robotronik/cdfr2020ShieldCerveauCapteursActionneursElec/README.txt

Ce fichier a pour but d'expliciter les différents composants de la carte électronique afin d'en faciliter la compréhension.

LevelShifter_ToF :
