robotronik/cdfr2020ShieldCerveauCapteursActionneursElec/shield_etage2.kicad_pcb

## KiCad design shield_etage2.kicad_pcb (2020-07-10)

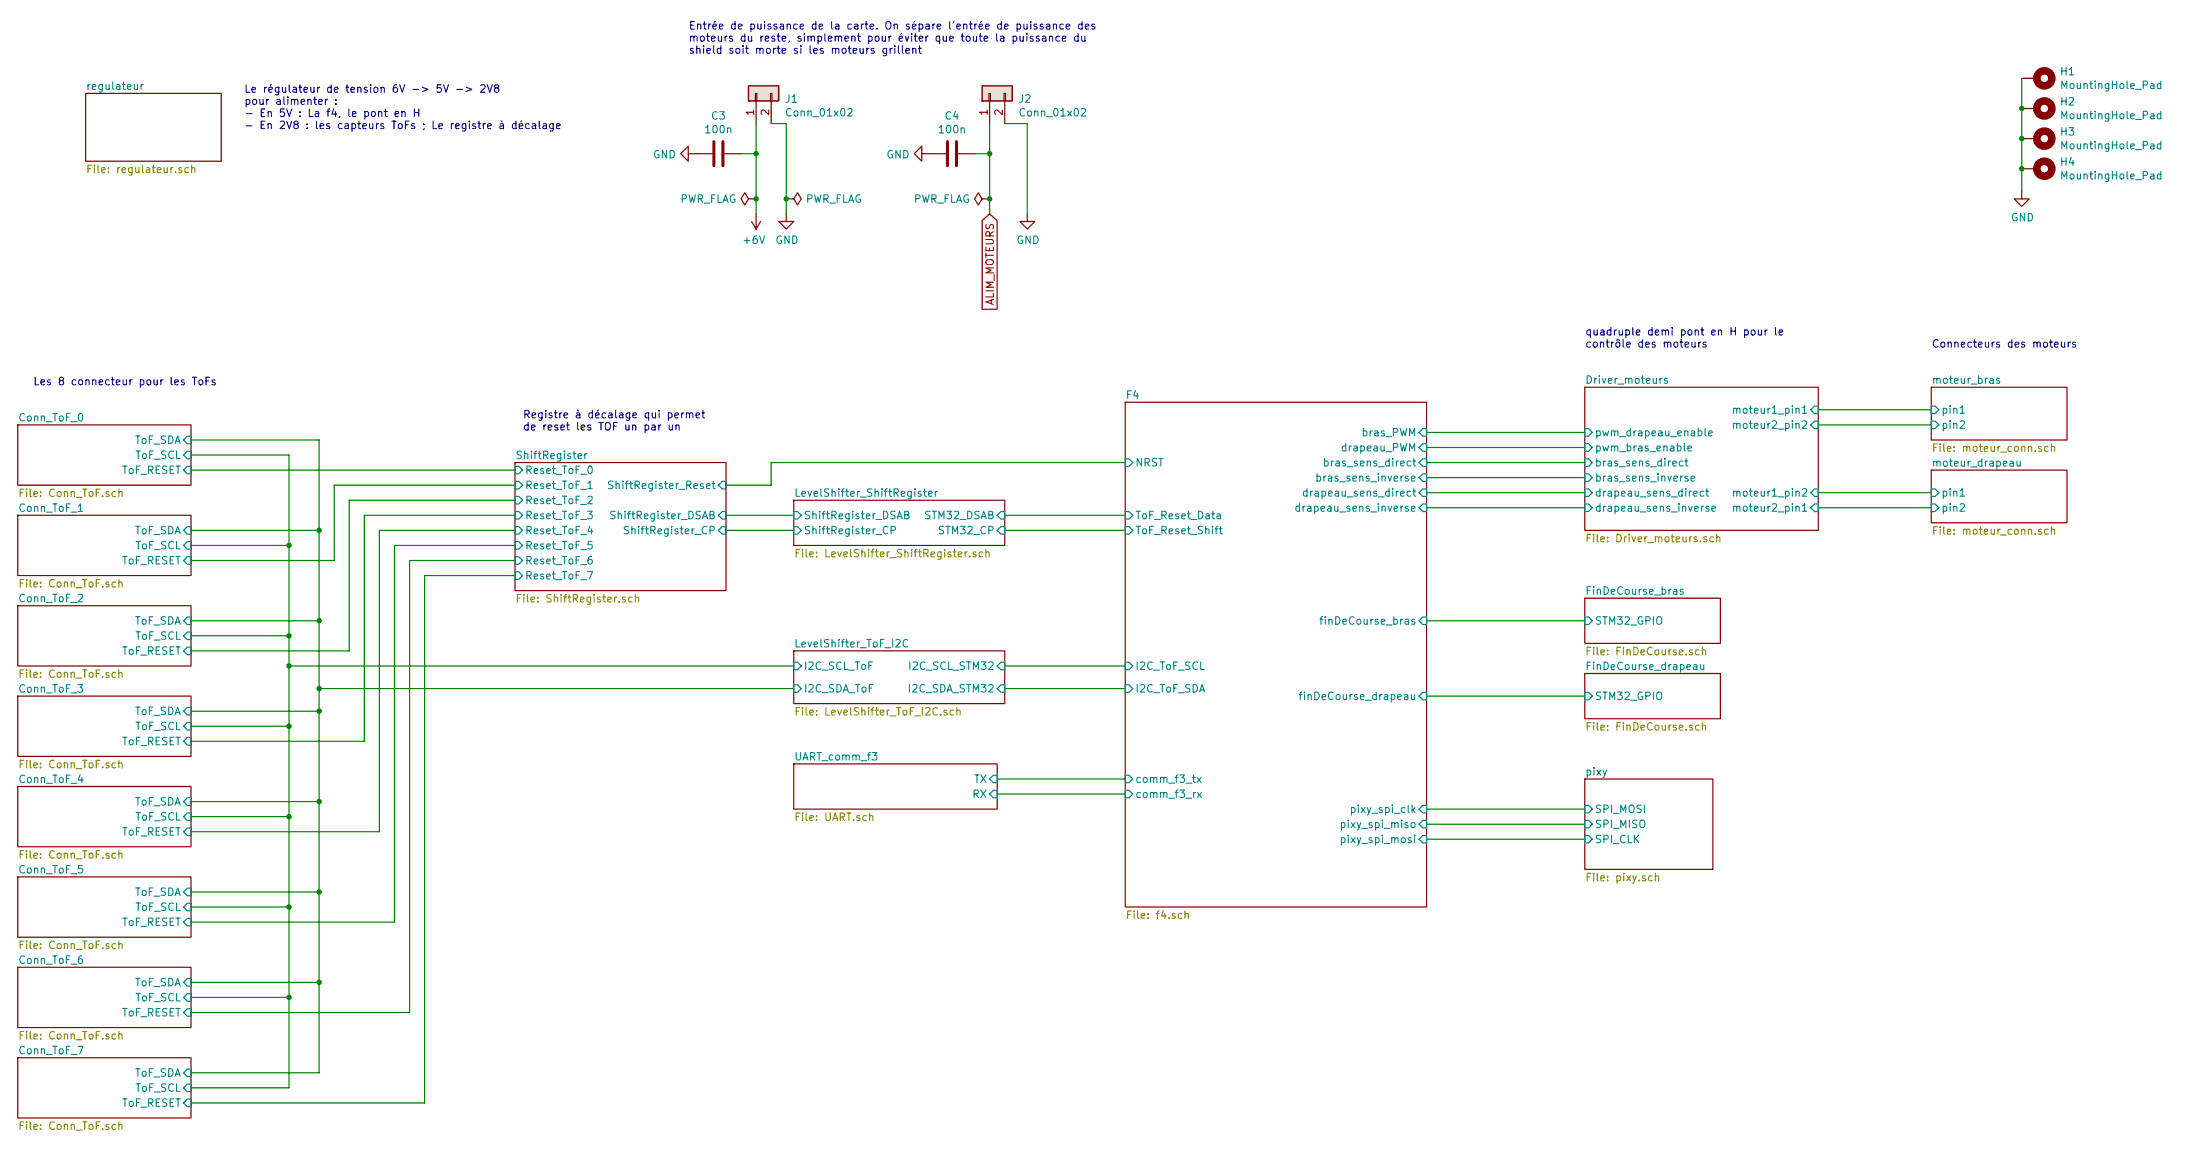
[picture p1: schematic shield_etage2.sch]

Parts:
C3, C4: 100n; C_0805_2012Metric_Pad1.15x1.40mm_HandSolder
H1, H2, H3, H4: MountingHole_Pad; MountingHole_2.2mm_M2_Pad
J1, J2: Conn_01x02; JST_EH_B2B-EH-A_1x02_P2.50mm_Vertical

Connections:
+6V: C3.1, J1.1; also elsewhere on the board
ALIM_MOTEURS: C4.1, J2.1; also elsewhere on the board
GND: C3.2, C4.2, H1.1, H2.1, H3.1, H4.1, J1.2, J2.2; also elsewhere on the board

Notes on the sheet:
Les 8 connecteur pour les ToFs
Registre à décalage qui permet de reset les TOF un par un
quadruple demi pont en H pour le contrôle des moteurs
Connecteurs des moteurs
Le régulateur de tension 6V -> 5V -> 2V8 pour alimenter : - En 5V : La f4, le pont en H - En 2V8 : les capteurs ToFs ; Le registre à décalage
Entrée de puissance de la carte. On sépare l'entrée de puissance des moteurs du reste, simplement pour éviter que toute la puissance du shield soit morte si les moteurs grillent

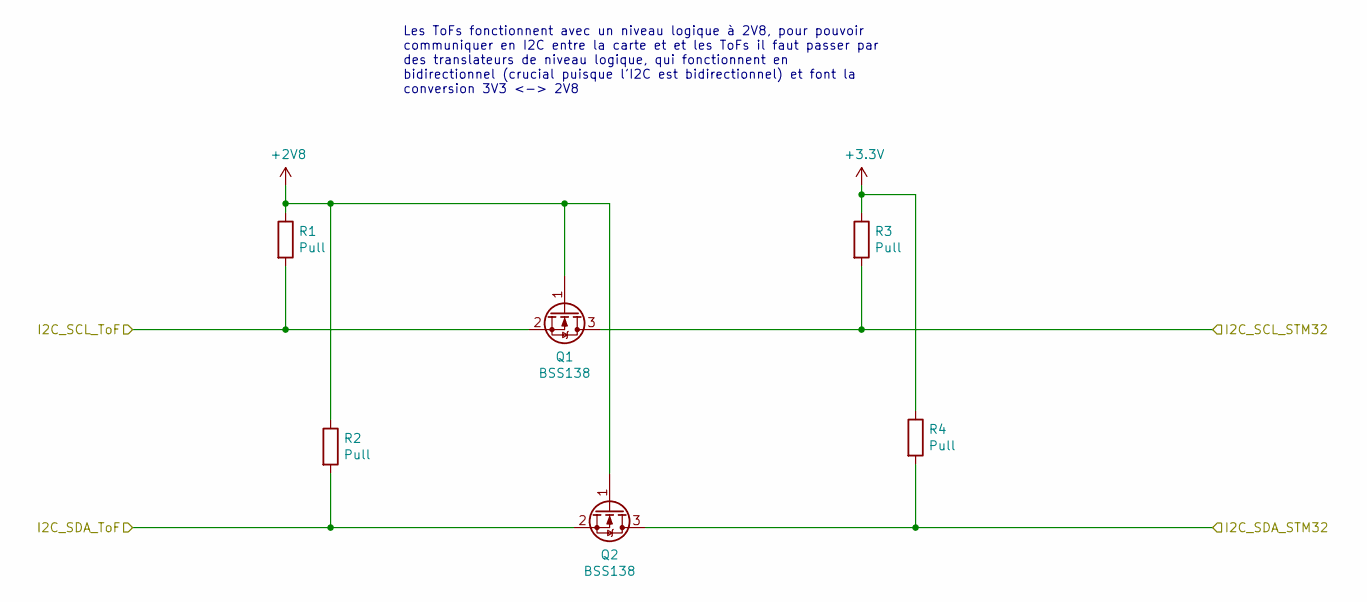
[picture p2: schematic LevelShifter_ToF_I2C.sch]

Parts:
Q1, Q2: BSS138; SOT-23
R1, R2, R3, R4: Pull; R_0805_2012Metric_Pad1.15x1.40mm_HandSolder

Connections:
+2V8: Q1.1 (G), Q2.1 (G), R1.1, R2.1; also elsewhere on the board
/LevelShifter_ToF_I2C/I2C_SCL_STM32: Q1.3 (D), R3.2; also elsewhere on the board
/LevelShifter_ToF_I2C/I2C_SCL_ToF: Q1.2 (S), R1.2; also elsewhere on the board
/LevelShifter_ToF_I2C/I2C_SDA_STM32: Q2.3 (D), R4.2; also elsewhere on the board
/LevelShifter_ToF_I2C/I2C_SDA_ToF: Q2.2 (S), R2.2; also elsewhere on the board

Notes on the sheet:
Les ToFs fonctionnent avec un niveau logique à 2V8, pour pouvoir communiquer en I2C entre la carte et et les ToFs il faut passer par des translateurs de niveau logique, qui fonctionnent en bidirectionnel (crucial puisque l'I2C est bidirectionnel) et font la conversion 3V3 <-> 2V8

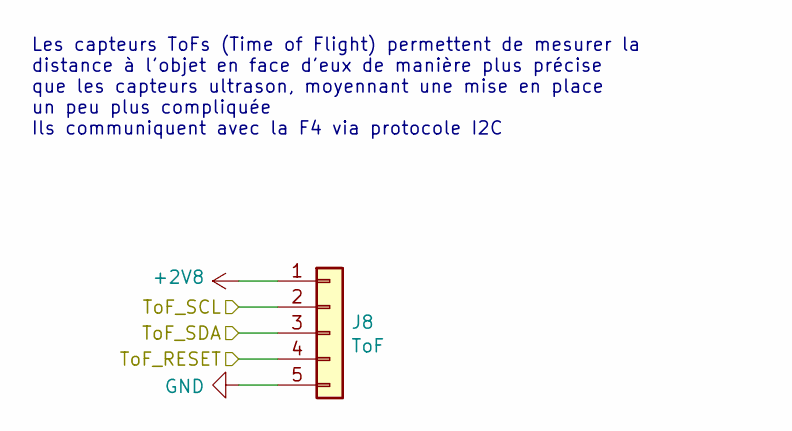
[picture p3: schematic Conn_ToF.sch]

Parts:
J3: ToF; JST_PH_B5B-PH-K_1x05_P2.00mm_Vertical

Connections:
+2V8: J3.1; also elsewhere on the board
/LevelShifter_ToF_I2C/I2C_SCL_ToF: J3.2; also elsewhere on the board
/LevelShifter_ToF_I2C/I2C_SDA_ToF: J3.3; also elsewhere on the board
/ShiftRegister/Reset_ToF_0: J3.4; also elsewhere on the board
GND: J3.5; also elsewhere on the board

Parts of its further copies:
J4, J5, J6, J7, J8, J9, J10: ToF; JST_PH_B5B-PH-K_1x05_P2.00mm_Vertical

Connections of its further copies:
+2V8: J4.1, J5.1, J6.1, J7.1, J8.1, J9.1, J10.1; also elsewhere on the board
/LevelShifter_ToF_I2C/I2C_SCL_ToF: J4.2, J5.2, J6.2, J7.2, J8.2, J9.2, J10.2; also elsewhere on the board
/LevelShifter_ToF_I2C/I2C_SDA_ToF: J4.3, J5.3, J6.3, J7.3, J8.3, J9.3, J10.3; also elsewhere on the board
/ShiftRegister/Reset_ToF_1: J4.4; also elsewhere on the board
/ShiftRegister/Reset_ToF_2: J5.4; also elsewhere on the board
/ShiftRegister/Reset_ToF_3: J6.4; also elsewhere on the board
/ShiftRegister/Reset_ToF_4: J7.4; also elsewhere on the board
/ShiftRegister/Reset_ToF_5: J8.4; also elsewhere on the board
/ShiftRegister/Reset_ToF_6: J9.4; also elsewhere on the board
/ShiftRegister/Reset_ToF_7: J10.4; also elsewhere on the board
GND: J4.5, J5.5, J6.5, J7.5, J8.5, J9.5, J10.5; also elsewhere on the board

Notes on the sheet:
Les capteurs ToFs (Time of Flight) permettent de mesurer la distance à l'objet en face d'eux de manière plus précise que les capteurs ultrason, moyennant une mise en place un peu plus compliquée Ils communiquent avec la F4 via protocole I2C

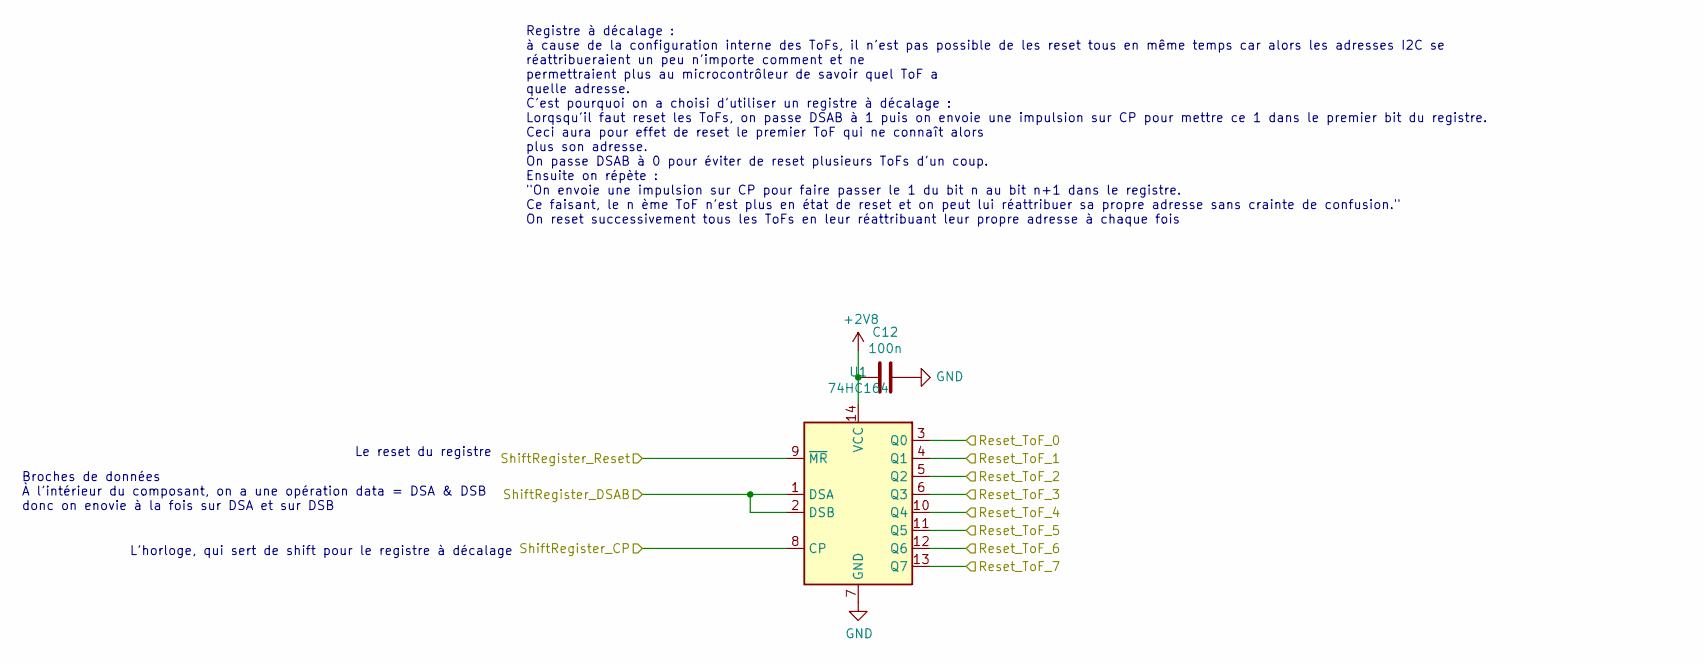
[picture p4: schematic ShiftRegister.sch]

Parts:
C12: 100n; C_0805_2012Metric_Pad1.15x1.40mm_HandSolder
U1: 74HC164; SOIC-14_3.9x8.7mm_P1.27mm

Connections:
+2V8: C12.2, U1.14 (VCC); also elsewhere on the board
/F4/NRST: U1.9 (~MR); also elsewhere on the board
/LevelShifter_ShiftRegister/ShiftRegister_CP: U1.8 (CP); also elsewhere on the board
/LevelShifter_ShiftRegister/ShiftRegister_DSAB: U1.1 (DSA), U1.2 (DSB); also elsewhere on the board
/ShiftRegister/Reset_ToF_0: U1.3 (Q0); also elsewhere on the board
/ShiftRegister/Reset_ToF_1: U1.4 (Q1); also elsewhere on the board
/ShiftRegister/Reset_ToF_2: U1.5 (Q2); also elsewhere on the board
/ShiftRegister/Reset_ToF_3: U1.6 (Q3); also elsewhere on the board
/ShiftRegister/Reset_ToF_4: U1.10 (Q4); also elsewhere on the board
/ShiftRegister/Reset_ToF_5: U1.11 (Q5); also elsewhere on the board
/ShiftRegister/Reset_ToF_6: U1.12 (Q6); also elsewhere on the board
/ShiftRegister/Reset_ToF_7: U1.13 (Q7); also elsewhere on the board
GND: C12.1, U1.7 (GND); also elsewhere on the board

Notes on the sheet:
Broches de données À l'intérieur du composant, on a une opération data = DSA & DSB donc on enovie à la fois sur DSA et sur DSB
L'horloge, qui sert de shift pour le registre à décalage
Le reset du registre
Registre à décalage : à cause de la configuration interne des ToFs, il n'est pas possible de les reset tous en même temps car alors les adresses I2C se réattribueraient un peu n'importe comment et ne permettraient plus au microcontrôleur de savoir quel ToF a quelle adresse. C'est pourquoi on a choi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

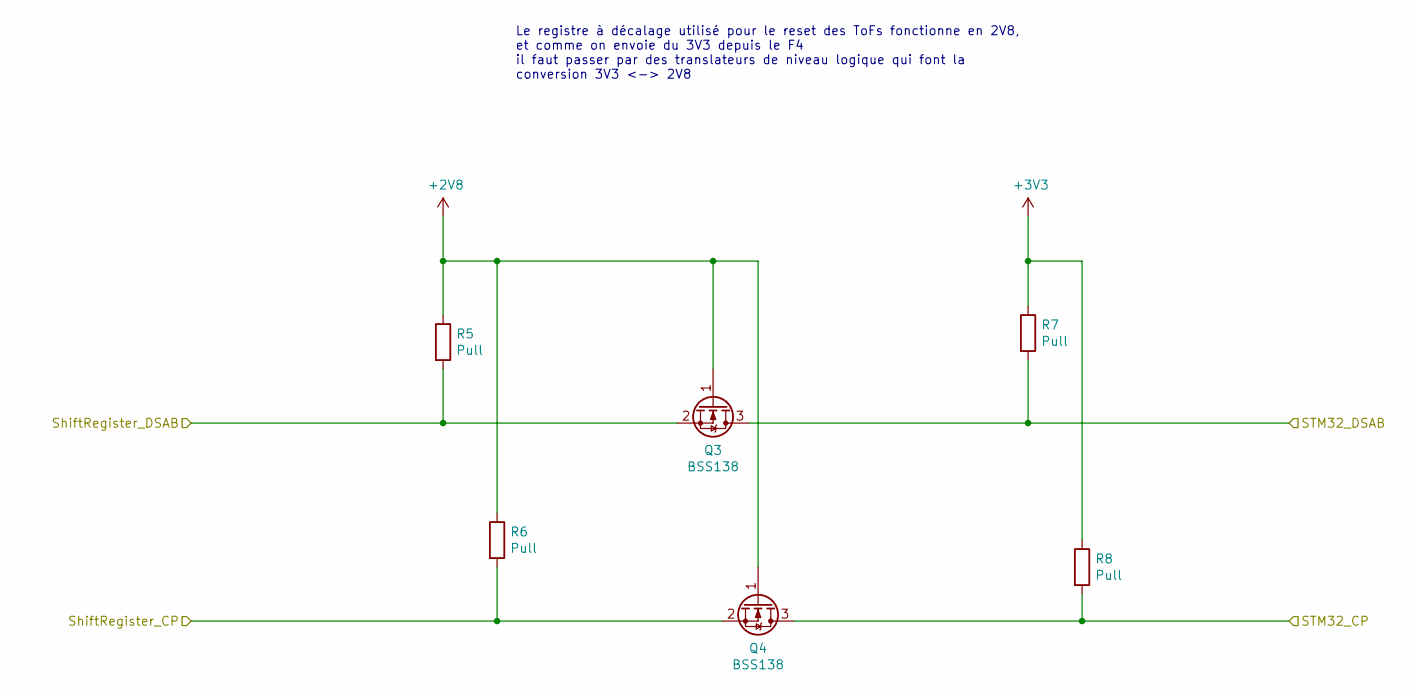
[picture p5: schematic LevelShifter_ShiftRegister.sch]

Parts:
Q3, Q4: BSS138; SOT-23
R5, R6, R7, R8: Pull; R_0805_2012Metric_Pad1.15x1.40mm_HandSolder

Connections:
+2V8: Q3.1 (G), Q4.1 (G), R5.1, R6.1; also elsewhere on the board
/LevelShifter_ShiftRegister/STM32_CP: Q4.3 (D), R8.2; also elsewhere on the board
/LevelShifter_ShiftRegister/STM32_DSAB: Q3.3 (D), R7.2; also elsewhere on the board
/LevelShifter_ShiftRegister/ShiftRegister_CP: Q4.2 (S), R6.2; also elsewhere on the board
/LevelShifter_ShiftRegister/ShiftRegister_DSAB: Q3.2 (S), R5.2; also elsewhere on the board

Notes on the sheet:
Le registre à décalage utilisé pour le reset des ToFs fonctionne en 2V8, et comme on envoie du 3V3 depuis le F4 il faut passer par des translateurs de niveau logique qui font la conversion 3V3 <-> 2V8

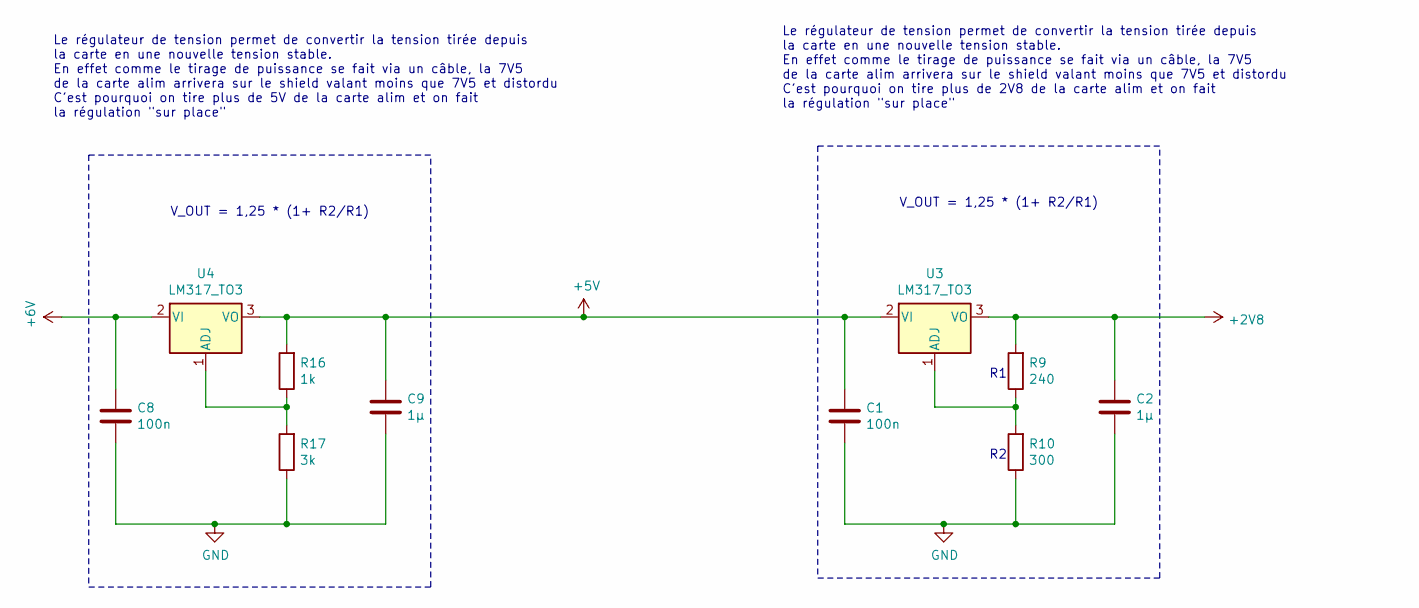
[picture p6: schematic regulateur.sch]

Parts:
C1, C8: 100n; C_0805_2012Metric_Pad1.15x1.40mm_HandSolder
C2, C9: 1µ; C_0805_2012Metric_Pad1.15x1.40mm_HandSolder
R9: 240; R_0805_2012Metric_Pad1.15x1.40mm_HandSolder
R10: 300; R_0805_2012Metric_Pad1.15x1.40mm_HandSolder
R16: 1k; R_0805_2012Metric_Pad1.15x1.40mm_HandSolder
R17: 3k; R_0805_2012Metric_Pad1.15x1.40mm_HandSolder
U3, U4: LM317_TO3; TO-220-3_Vertical

Connections:
+2V8: C2.1, R9.2, U3.3 (VO); also elsewhere on the board
+5V: C1.1, C9.1, R16.2, U3.2 (VI), U4.3 (VO); also elsewhere on the board
+6V: C8.1, U4.2 (VI); also elsewhere on the board
GND: C1.2, C2.2, C8.2, C9.2, R10.1, R17.1; also elsewhere on the board
unnamed: R9.1, R10.2, U3.1 (ADJ)
unnamed: R16.1, R17.2, U4.1 (ADJ)

Notes on the sheet:
V_OUT = 1,25 * (1+ R2/R1)
Le régulateur de tension permet de convertir la tension tirée depuis la carte en une nouvelle tension stable. En effet comme le tirage de puissance se fait via un câble, la 7V5 de la carte alim arrivera sur le shield valant moins que 7V5 et distordu C'est pourquoi on tire plus de 5V de la carte ali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
Le régulateur de tension permet de convertir la tension tirée depuis la carte en une nouvelle tension stable. En effet comme le tirage de puissance se fait via un câble, la 7V5 de la carte alim arrivera sur le shield valant moins que 7V5 et distordu C'est pourquoi on tire plus de 2V8 de la carte al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

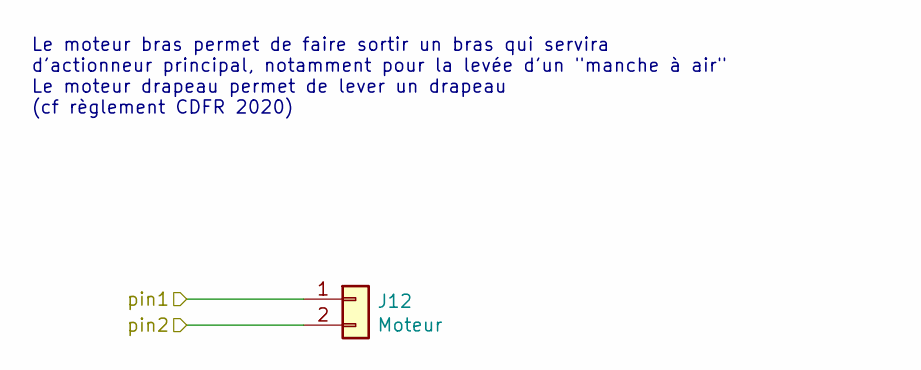
[picture p7: schematic moteur_conn.sch]

Parts:
J12: Moteur; JST_PH_B2B-PH-K_1x02_P2.00mm_Vertical

Connections:
/Driver_moteurs/moteur1_pin2: J12.1; also elsewhere on the board
/Driver_moteurs/moteur2_pin1: J12.2; also elsewhere on the board

Parts of its further copies:
J11: Moteur; JST_PH_B2B-PH-K_1x02_P2.00mm_Vertical

Connections of its further copies:
/Driver_moteurs/moteur1_pin1: J11.1; also elsewhere on the board
/Driver_moteurs/moteur2_pin2: J11.2; also elsewhere on the board

Notes on the sheet:
Le moteur bras permet de faire sortir un bras qui servira d'actionneur principal, notamment pour la levée d'un "manche à air" Le moteur drapeau permet de lever un drapeau (cf règlement CDFR 2020)

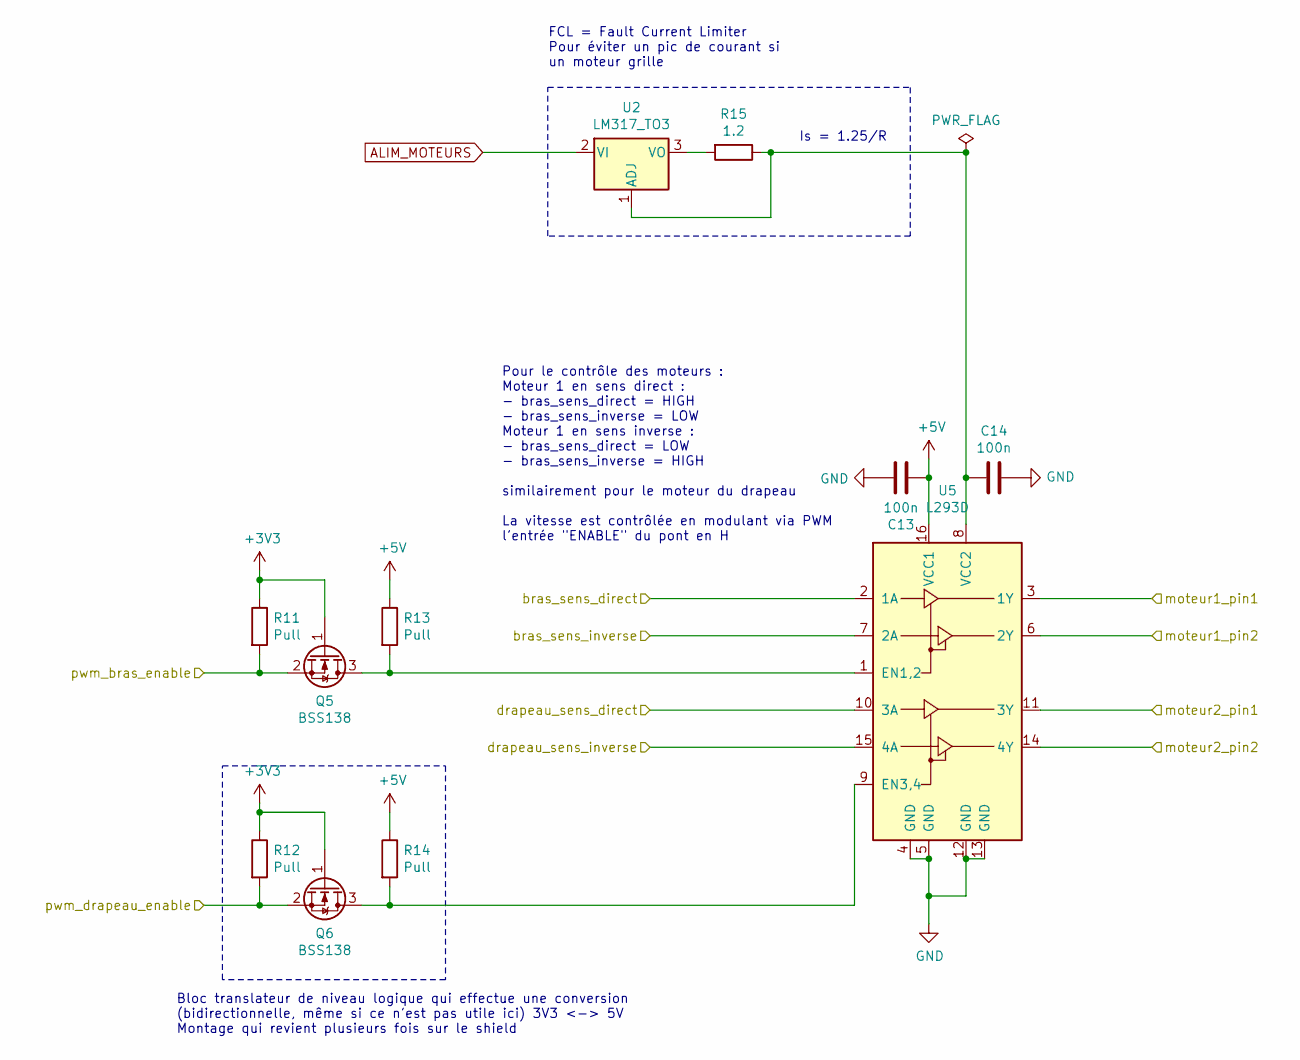
[picture p8: schematic Driver_moteurs.sch]

Parts:
C13, C14: 100n; C_0805_2012Metric_Pad1.15x1.40mm_HandSolder
Q5, Q6: BSS138; SOT-23
R11, R12, R13, R14: Pull; R_0805_2012Metric_Pad1.15x1.40mm_HandSolder
R15: 1.2; R_Axial_DIN0414_L11.9mm_D4.5mm_P15.24mm_Horizontal
U2: LM317_TO3; TO-220-3_Vertical
U5: L293D; DIP-16_W7.62mm

Connections:
+5V: C13.2, R13.1, R14.1, U5.16 (VCC1); also elsewhere on the board
/Driver_moteurs/bras_sens_direct: U5.2 (1A); also elsewhere on the board
/Driver_moteurs/bras_sens_inverse: U5.7 (2A); also elsewhere on the board
/Driver_moteurs/drapeau_sens_direct: U5.10 (3A); also elsewhere on the board
/Driver_moteurs/drapeau_sens_inverse: U5.15 (4A); also elsewhere on the board
/Driver_moteurs/moteur1_pin1: U5.3 (1Y); also elsewhere on the board
/Driver_moteurs/moteur1_pin2: U5.6 (2Y); also elsewhere on the board
/Driver_moteurs/moteur2_pin1: U5.11 (3Y); also elsewhere on the board
/Driver_moteurs/moteur2_pin2: U5.14 (4Y); also elsewhere on the board
/F4/bras_PWM: Q6.2 (S), R12.2; also elsewhere on the board
/F4/drapeau_PWM: Q5.2 (S), R11.2; also elsewhere on the board
ALIM_MOTEURS: U2.2 (VI); also elsewhere on the board
GND: C13.1, C14.1, U5.4 (GND), U5.5 (GND), U5.12 (GND), U5.13 (GND); also elsewhere on the board
unnamed: C14.2, R15.1, U2.1 (ADJ), U5.8 (VCC2)
unnamed: Q5.3 (D), R13.2, U5.1 (EN1,2)
unnamed: Q6.3 (D), R14.2, U5.9 (EN3,4)
unnamed: R15.2, U2.3 (VO)

Notes on the sheet:
FCL = Fault Current Limiter Pour éviter un pic de courant si un moteur grille
Is = 1.25/R
Bloc translateur de niveau logique qui effectue une conversion (bidirectionnelle, même si ce n'est pas utile ici) 3V3 <-> 5V Montage qui revient plusieurs fois sur le shield
Pour le contrôle des moteurs : Moteur 1 en sens direct : - bras_sens_direct = HIGH - bras_sens_inverse = LOW Moteur 1 en sens inverse : - bras_sens_direct = LOW - bras_sens_inverse = HIGH similairement pour le moteur du drapeau La vitesse est contrôlée en modulant via PWM l'entrée "ENABLE" du pont 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

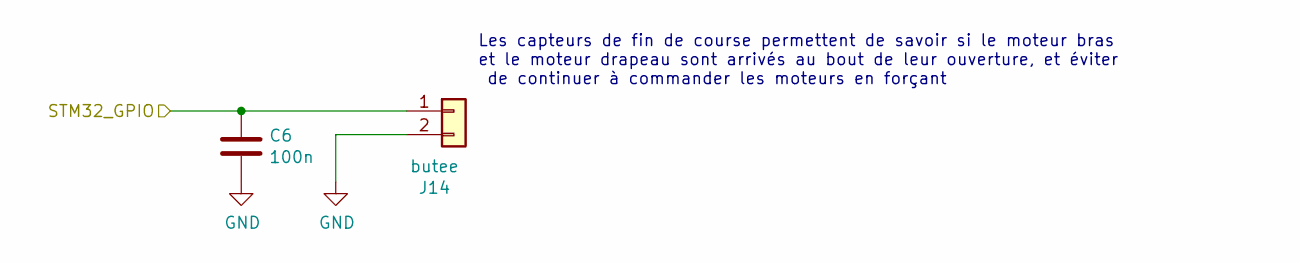
[picture p9: schematic FinDeCourse.sch]

Parts:
C6: 100n; C_0805_2012Metric_Pad1.15x1.40mm_HandSolder
J13: butee; JST_PH_B2B-PH-K_1x02_P2.00mm_Vertical

Connections:
GND: C6.2, J13.2; also elsewhere on the board

Parts of its further copies:
C7: 100n; C_0805_2012Metric_Pad1.15x1.40mm_HandSolder
J14: butee; JST_PH_B2B-PH-K_1x02_P2.00mm_Vertical

Connections of its further copies:
GND: C7.2, J14.2; also elsewhere on the board

Notes on the sheet:
Les capteurs de fin de course permettent de savoir si le moteur bras et le moteur drapeau sont arrivés au bout de leur ouverture, et éviter de continuer à commander les moteurs en forçant

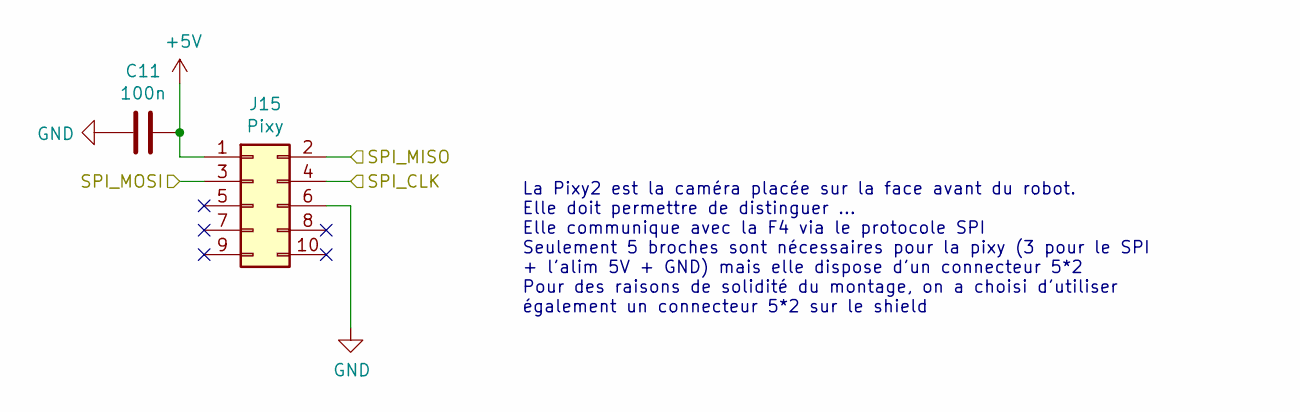
[picture p10: schematic pixy.sch]

Parts:
C11: 100n; C_0805_2012Metric_Pad1.15x1.40mm_HandSolder
J15: Pixy; JST_PHD_B10B-PHDSS_2x05_P2.00mm_Vertical

Connections:
+5V: C11.1, J15.1; also elsewhere on the board
/pixy/SPI_CLK: J15.4; also elsewhere on the board
/pixy/SPI_MISO: J15.2; also elsewhere on the board
/pixy/SPI_MOSI: J15.3; also elsewhere on the board
GND: C11.2, J15.6; also elsewhere on the board

Notes on the sheet:
La Pixy2 est la caméra placée sur la face avant du robot. Elle doit permettre de distinguer ... Elle communique avec la F4 via le protocole SPI Seulement 5 broches sont nécessaires pour la pixy (3 pour le SPI + l'alim 5V + GND) mais elle dispose d'un connecteur 5*2 Pour des raisons de solidité du m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

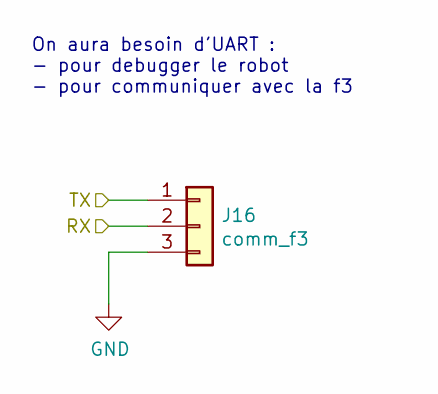
[picture p11: schematic UART.sch]

Parts:
J16: comm_f3; JST_EH_B3B-EH-A_1x03_P2.50mm_Vertical

Connections:
/UART_comm_f3/RX: J16.2; also elsewhere on the board
/UART_comm_f3/TX: J16.1; also elsewhere on the board
GND: J16.3; also elsewhere on the board

Notes on the sheet:
On aura besoin d'UART : - pour debugger le robot - pour communiquer avec la f3

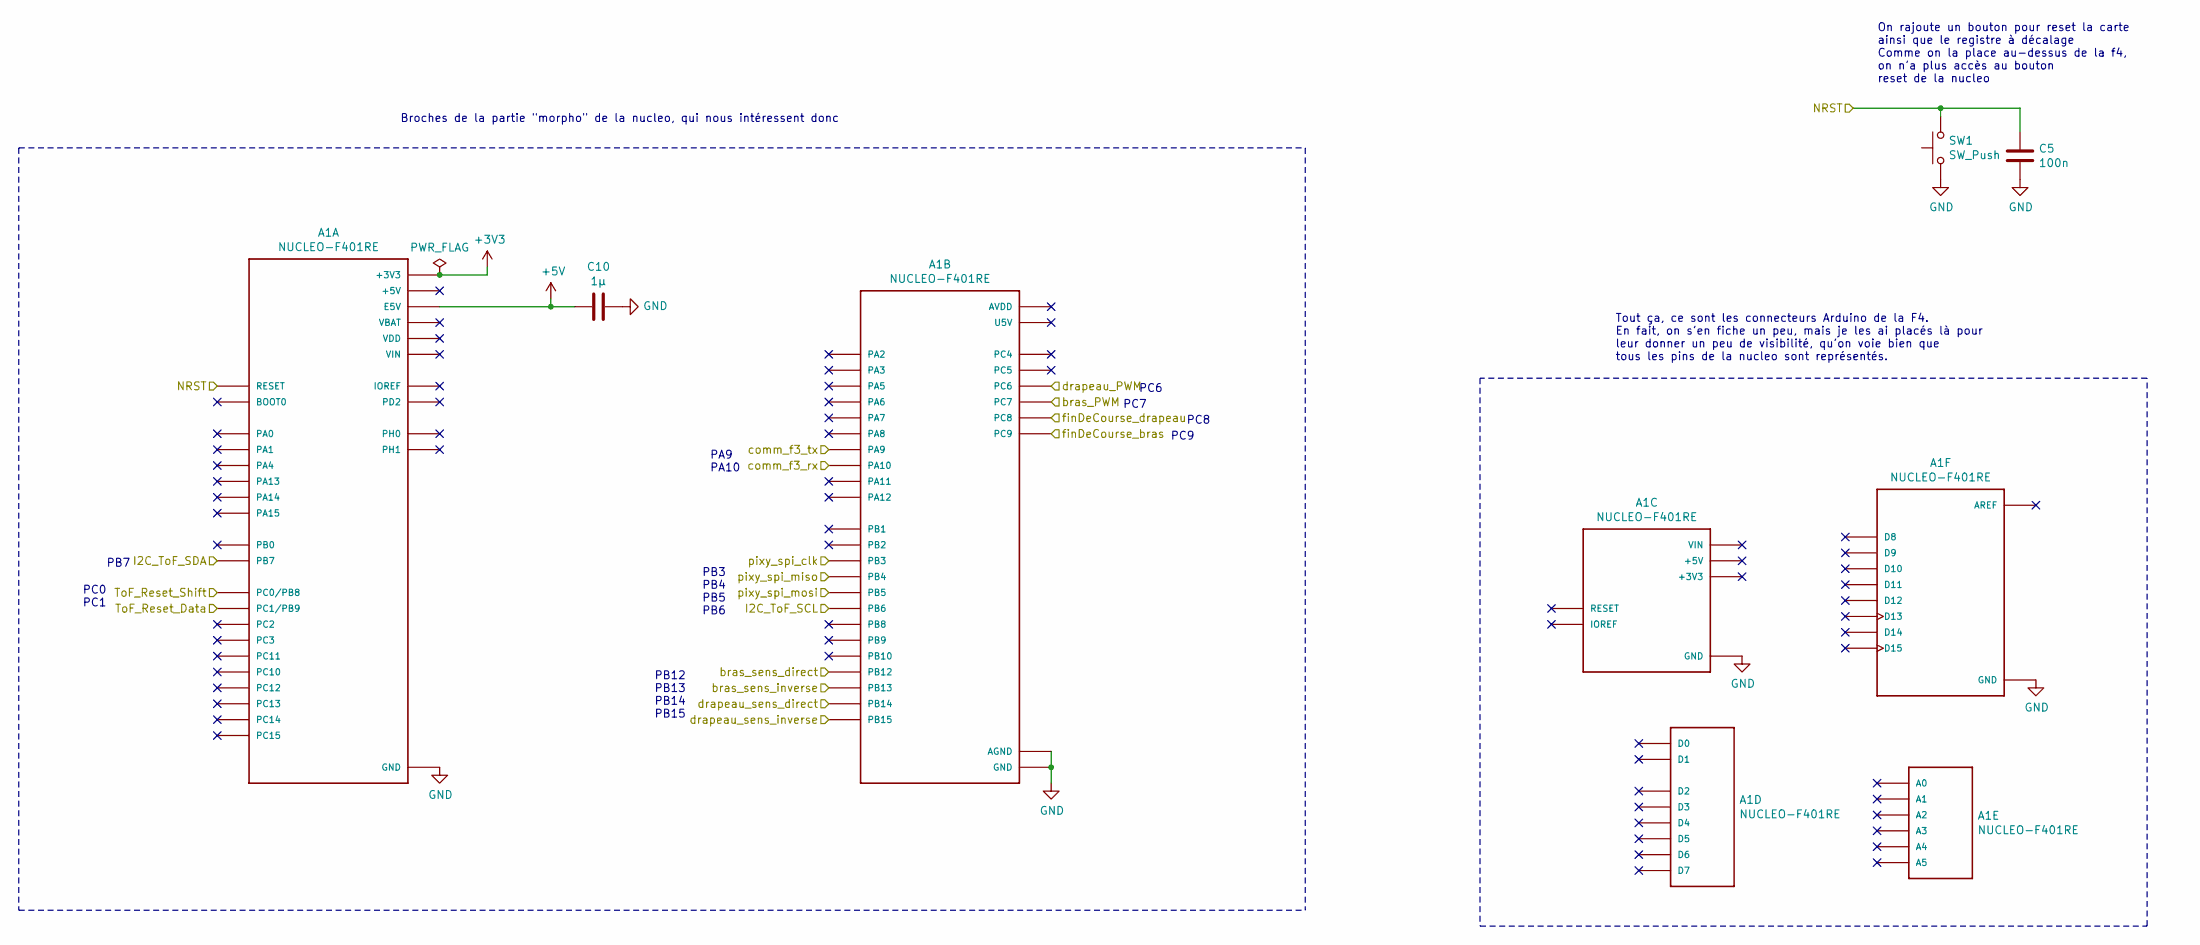
[picture p12: schematic f4.sch]

Parts:
A1: NUCLEO-F401RE; ST_NUCLEO-F401RE
C5: 100n; C_0805_2012Metric_Pad1.15x1.40mm_HandSolder
C10: 1µ; C_0805_2012Metric_Pad1.15x1.40mm_HandSolder
SW1: SW_Push; SW_Push_1P1T_NO_6x6mm_H9.5mm

Connections:
+5V: A1.CN7_6 (E5V), C10.1; also elsewhere on the board
/Driver_moteurs/bras_sens_direct: A1.CN10_16 (PB12); also elsewhere on the board
/Driver_moteurs/bras_sens_inverse: A1.CN10_30 (PB13); also elsewhere on the board
/Driver_moteurs/drapeau_sens_direct: A1.CN10_28 (PB14); also elsewhere on the board
/Driver_moteurs/drapeau_sens_inverse: A1.CN10_26 (PB15); also elsewhere on the board
/F4/NRST: A1.CN7_14 (RESET), C5.1, SW1.2; also elsewhere on the board
/F4/bras_PWM: A1.CN10_19 (PC7); also elsewhere on the board
/F4/drapeau_PWM: A1.CN10_4 (PC6); also elsewhere on the board
/LevelShifter_ShiftRegister/STM32_CP: A1.CN7_38 (PC0/PB8); also elsewhere on the board
/LevelShifter_ShiftRegister/STM32_DSAB: A1.CN7_36 (PC1/PB9); also elsewhere on the board
/LevelShifter_ToF_I2C/I2C_SCL_STM32: A1.CN10_17 (PB6); also elsewhere on the board
/LevelShifter_ToF_I2C/I2C_SDA_STM32: A1.CN7_21 (PB7); also elsewhere on the board
/UART_comm_f3/RX: A1.CN10_33 (PA10); also elsewhere on the board
/UART_comm_f3/TX: A1.CN10_21 (PA9); also elsewhere on the board
/pixy/SPI_CLK: A1.CN10_29 (PB5); also elsewhere on the board
/pixy/SPI_MISO: A1.CN10_27 (PB4); also elsewhere on the board
/pixy/SPI_MOSI: A1.CN10_31 (PB3); also elsewhere on the board
GND: A1.CN5_7 (GND), A1.CN6_6 (GND), A1.CN6_7 (GND), A1.CN7_8 (GND), A1.CN7_19 (GND), A1.CN7_20 (GND), A1.CN7_22 (GND), A1.CN10_9 (GND), A1.CN10_20 (GND), A1.CN10_32 (AGND), C5.2, C10.2, SW1.1; also elsewhere on the board

Notes on the sheet:
On rajoute un bouton pour reset la carte ainsi que le registre à décalage Comme on la place au-dessus de la f4, on n'a plus accès au bouton reset de la nucleo
PC0 PC1
PA9 PA10
PB12 PB13 PB14 PB15
PB3 PB4 PB5 PB6
PC9
PC8
PC6
PC7
PB7
Tout ça, ce sont les connecteurs Arduino de la F4. En fait, on s'en fiche un peu, mais je les ai placés là pour leur donner un peu de visibilité, qu'on voie bien que tous les pins de la nucleo sont représentés.
Broches de la partie "morpho" de la nucleo, qui nous intéressent donc

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
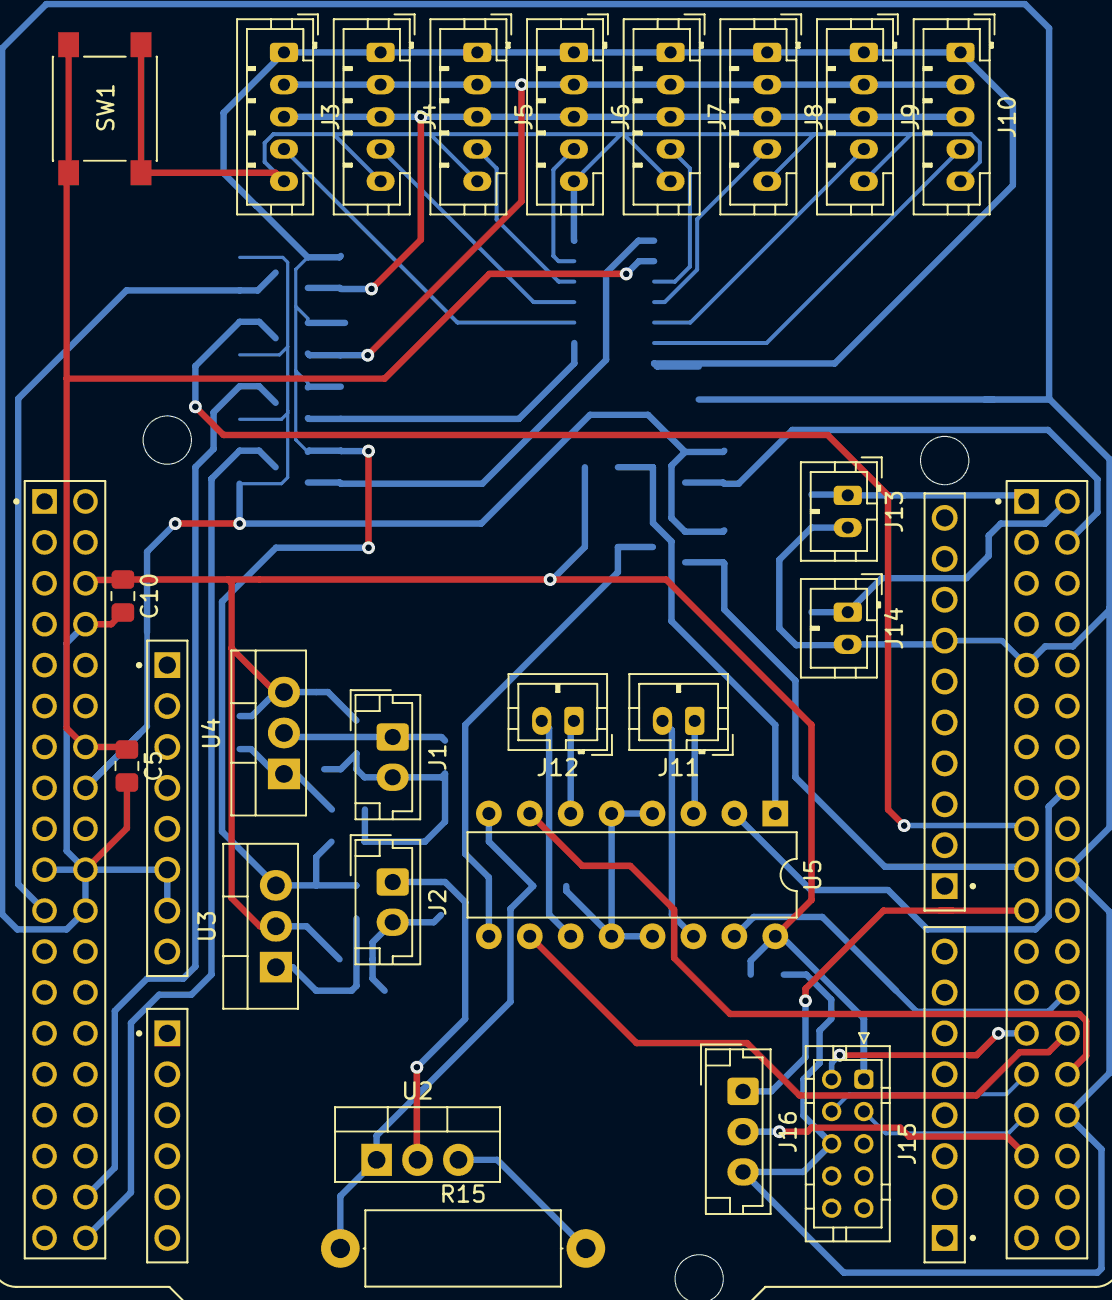
[picture p13: board shield_etage2.kicad_pcb from above]

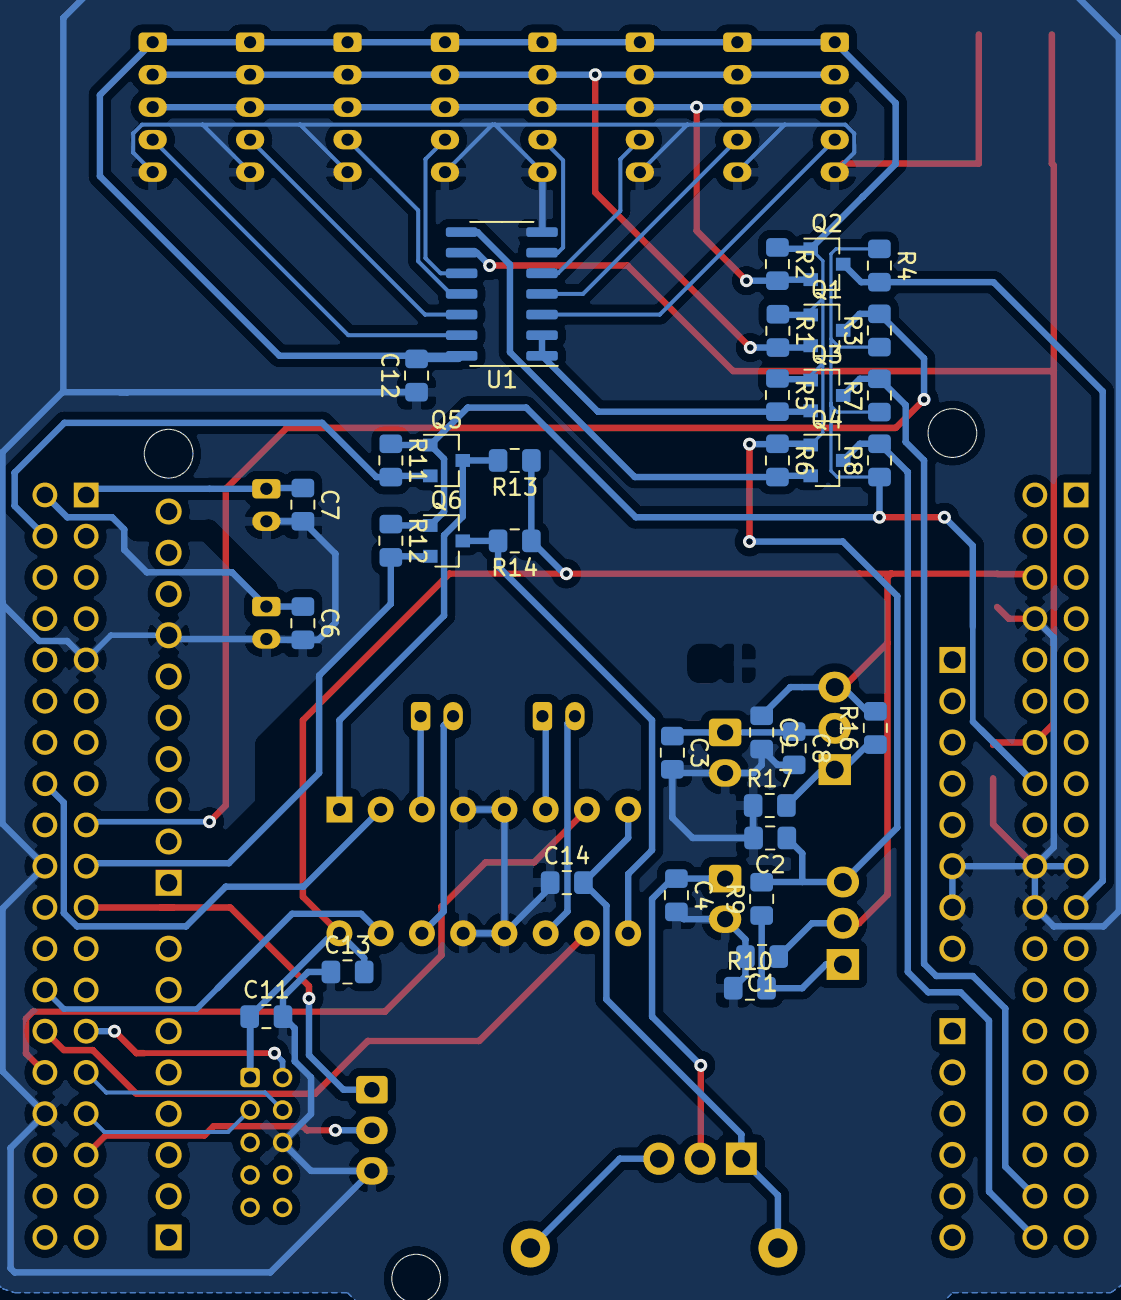
[picture p14: board shield_etage2.kicad_pcb from below]

Board: 2 copper layers, 60 parts (35 on the bottom side), 46 nets.
