robotronik/cdfr2020ShieldCerveauCapteursActionneursElec/(commit log)

2020-06-30 avancement général du routage
    [Conn_ToF.sch, Driver_moteurs.sch, FinDeCourse.sch, LevelShifter_ShiftRegister.sch, LevelShifter_ToF_I2C.sch, ShiftRegister.sch, UART.sch, f4.sch]
2020-07-03 première version du routage complète
    [shield_etage2.kicad_pcb]
2020-07-10 Correction de défauts, quelques pistes refaites plus proprement
    [shield_etage2.kicad_pcb]
